Chia-Network/asic-timelord-enclosure/stl/front_frame.stl

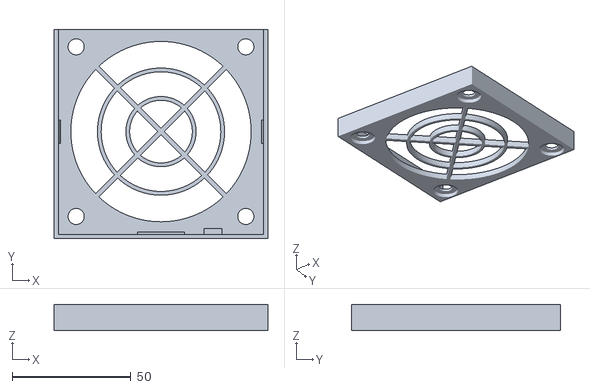
[picture p3: CAD file, 2026-10-28]
stl/front_frame.stl
90.2 x 88.2 x 11.0
