Chia-Network/asic-timelord-enclosure/stl/tube.stl

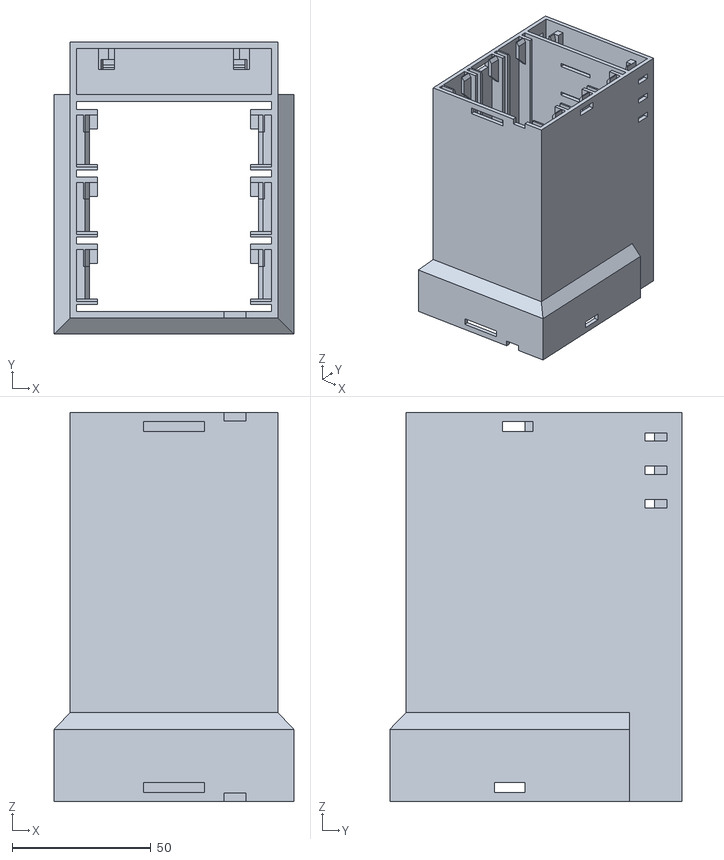
[picture p4: CAD file, 2026-10-28]
stl/tube.stl
86.2 x 105.2 x 140.0
