Chia-Network/asic-timelord-enclosure/stl/back_frame.stl

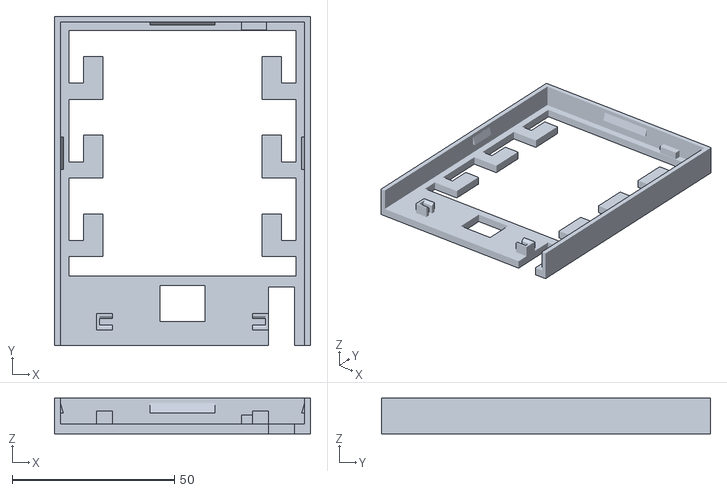
[picture p5: CAD file, 2026-10-28]
stl/back_frame.stl
78.8 x 101.4 x 11.0
